ulyssecrn/PCBGolf/assets/renders/hero-bottom.png

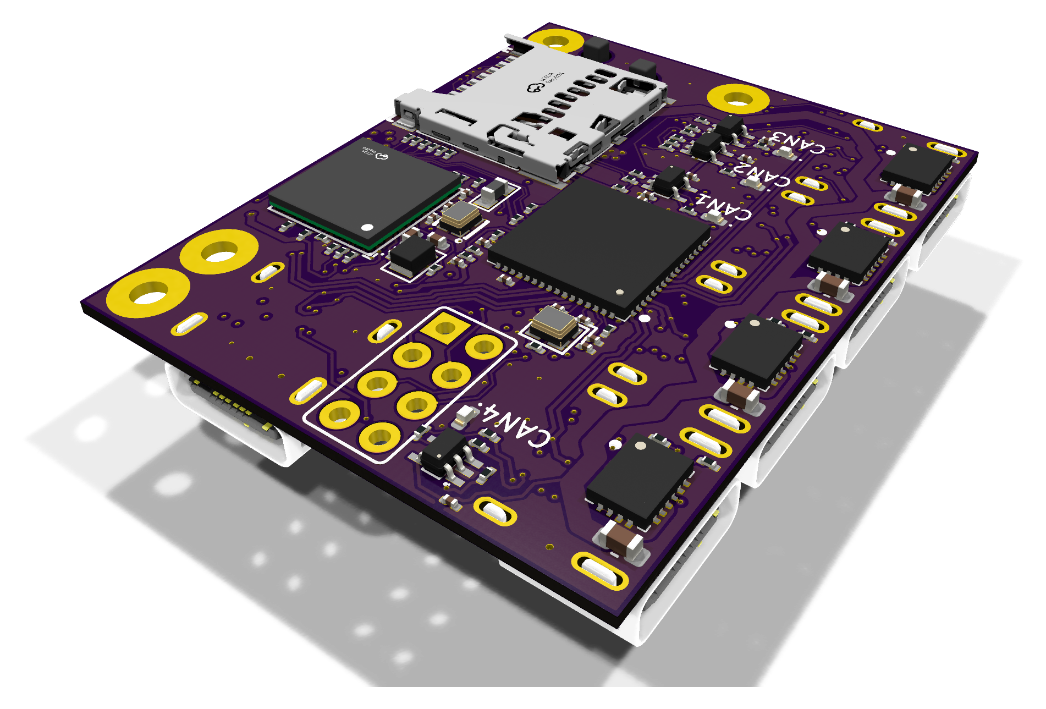
assets/renders/hero-bottom.png
