ulyssecrn/PCBGolf/pcbgolf.kicad_pcb

## KiCad design pcbgolf.kicad_pcb (2026-10-13)

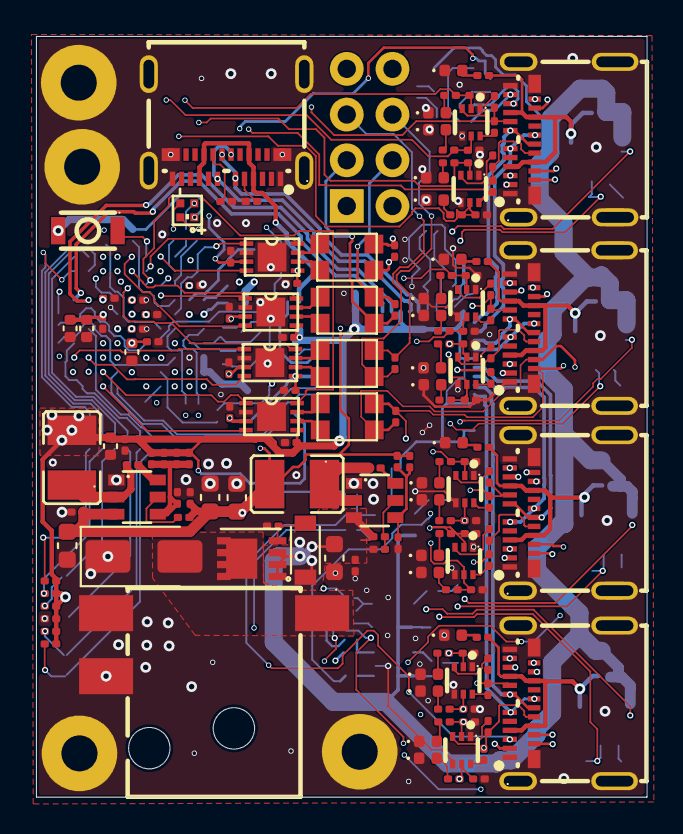
[picture p5: board pcbgolf.kicad_pcb from above]

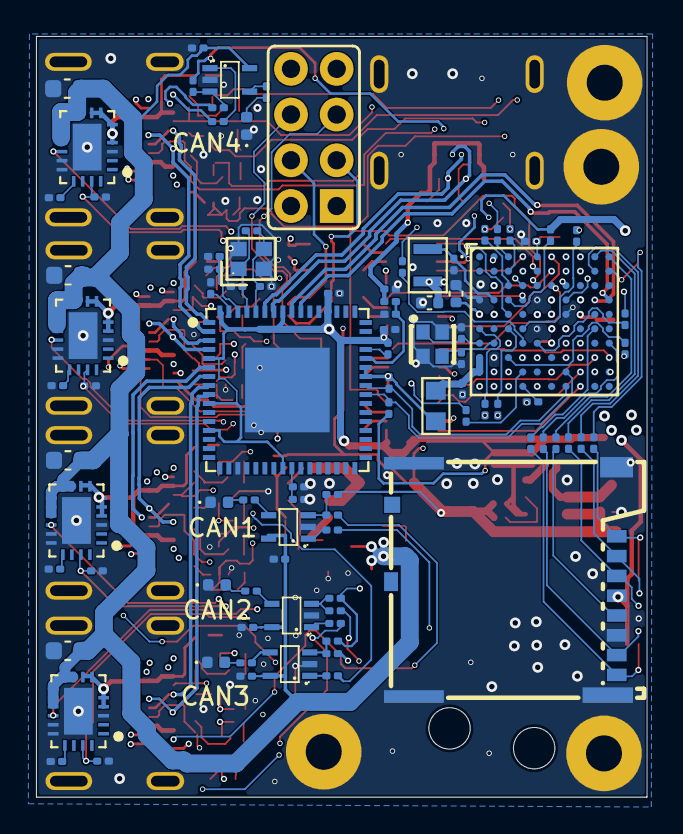
[picture p6: board pcbgolf.kicad_pcb from below]

Board: 4 copper layers, 33.9 x 42.3 mm, 253 parts (93 on the bottom side), 196 nets.

Parts:
BH1, BH2, BH3, BH4: M2_BOLT
C1, C3, C12, C13: 10uF; C_0603_1608Metric
C2, C4, C5, C7, C9, C11, C16, C18, C22, C23, C24, C26, C27, C30, C31, C35, C36, C38, C39, C40, C41, C42, C43, C44, C45, C46, C47, C48, C49, C55: 100nF; C_0201_0603Metric
C6, C10: DNP; C_0201_0603Metric
C8, C15, C19, C20, C21: 10uF; C_0402_1005Metric
C14, C17, C28, C32: 12pF; C_0201_0603Metric
C25: 220pF; C_0201_0603Metric
C29, C33, C34, C37: 10u; C_0201_0603Metric
C50, C51, C52, C53: 10u; C_0603_1608Metric
C54: 4.7uF; C_0402_1005Metric
D1: TVS-BI-DO214AA; D_SMA
D2: DIODEDB2W40100L; SOD-123F
J1: DCBARRELSMT; DC-IN-SMD_DC-044D-2.5A-2.0-SMT
J2: MICRO_SD-0472192001; microSD_Molex_5033981892
J3: USB-C-FEMALE; USB-C-J3-molex
J4: CAN; 2X04
J5, J6, J7, J8: USB-C-FEMALEGCT; USB-C-SMD_TYPE-C-USB-18
L1, L2: 3u3; IND_3225_3R3
L3: L-US-L2; 0603-L
L4: 2u2; 0806
L5, L6, L7, L8: ACT1210D_CHOKE; CHOKE-3.2X2.5
LED1: CREE-RGB-CLMVC; RGB_NH-B1010
LED2: CAN0; LED_0402_1005Metric
LED3: CAN1; LED_0402_1005Metric
LED4: CAN2; LED_0402_1005Metric
LED5: CAN3; LED_0402_1005Metric
LED6, LED7, LED8, LED9: CH1_PWR; LED_0402_1005Metric
LED10, LED11, LED12, LED13, LED14, LED15, LED16, LED17: LED_RED_0402; LED_0402_1005Metric
LED30, LED31, LED32, LED33, LED34, LED35, LED36, LED37: LED_GREEN_0402; LED_0402_1005Metric
Q1: SIS427-VI; PP-1212-8
Q2, Q3, Q4, Q5, Q6, Q7, Q8, Q9: NFET-DUAL-COMMON-SOURCE-QS5K2; SSM6N44FE-SOT563-remap
R1, R3, R7, R8, R9, R11, R12, R28, R29, R30, R33, R34, R35, R36, R37, R50, R51, R53, R54, R56, R57, R59, R60, R78, R79, R80, R81, R98, R99, R100, R101, R102, R103, R104, R105, R122, R123, R124, R125: 10k; R_0201_0603Metric
R2, R21, R23, R90, R92, R94, R96, R114, R116, R118, R120: 1k; R_0201_0603Metric
R4, R5, R6, R13, R14, R15, R16, R17, R18, R19, R20, R24, R25, R52, R55, R58, R61: 100k; R_0201_0603Metric
R10: 52k3; R_0201_0603Metric
R22, R62, R63, R64, R65: 2k7; R_0201_0603Metric
R26: 1M; R_0201_0603Metric
R27: 12k; R_0201_0603Metric
R32, R44: 5.1k; R_0201_0603Metric
R38, R39, R40, R41, R42, R43: 0R; R_0201_0603Metric
R46, R47, R48, R49: 60; R_0201_0603Metric
R66, R67, R68, R69: 28k; R_0201_0603Metric
R70, R71, R72, R73: 33k; R_0201_0603Metric
R74, R75, R76, R77: 3k3; R_0201_0603Metric
R82, R83, R84, R85, R86, R87, R88, R89, R91, R93, R95, R97, R106, R107, R108, R109, R110, R111, R112, R113, R115, R117, R119, R121: 100; R_0201_0603Metric
SW1: SPST-2-4PIN; SW_TS2306A
U1, U2: AP62300T; SOT23-6
U3: STM32H725VGH6; STM32H725-TFBGA100-remap
U4: USB2517; QFN64-9X9
U5, U6, U7, U8: MCP2542FDT-E/MNY; TDFN8_2X3MC_MCH
U13, U14, U15, U16: TPS25942; WQFN20
U17, U18, U19, U20: TLV9101IDCKR; TLV9101-SC70-5
Y1: 25MHz; Crystal_2016_25M
Y2: 24MHz; Crystal_2016_24M

Connections:
+3V3: C6.2, C7.1, C8.1, C19.1, C20.1, C23.1, C24.1, C26.1, C27.1, C30.2, C31.2, C37.1, C42.1, C43.1, C44.1, C45.1, C54.1, C55.1, J2.4 (VDD), L1.2, L3.1, LED1.U1 (COM+), R4.1, R5.1, R6.1, R11.1, R28.1, R29.1, R30.1, R33.1, R34.1, R35.1, R36.1, R37.1, SW1.B (S), SW1.B' (S1), U3.7 (VDD), U3.8 (VBAT), U3.13 (VDD), U3.16 (VDDSMPS), U3.19 (VDD), U3.91 (VDD33USB), U4.5 (VDDA33), U4.10 (VDDA33), U4.13 (CFG_SEL2), U4.24 (VDD33CR), U4.42 (CFG_SEL1), U4.43 (RESET_N), U4.46 (VDD33), U4.52 (VDDA33), U4.57 (VDDA33), U4.64 (VDD33PLL), U5.5 (VIO), U6.5 (VIO), U7.5 (VIO), U8.5 (VIO)
+5V: C1.1, C2.1, C10.2, C11.1, C12.1, C13.1, C38.1, C39.1, C40.1, C41.1, L2.2, R1.1, R10.2, R52.2, R55.2, R58.2, R61.2, U1.3 (IN), U5.3 (VDD), U6.3 (VDD), U7.3 (VDD), U8.3 (VDD)
+12V: C3.1, C5.1, C46.1, C47.1, C48.1, C49.1, C50.1, C51.1, C52.1, C53.1, D2.1 (C), Q1.1 (S), Q1.2 (S), Q1.3 (S), R7.1, U2.3 (IN), U13.9 (VIN), U13.10 (VIN), U13.11 (VIN), U13.12 (VIN), U13.13 (VIN), U14.9 (VIN), U14.10 (VIN), U14.11 (VIN), U14.12 (VIN), U14.13 (VIN), U15.9 (VIN), U15.10 (VIN), U15.11 (VIN), U15.12 (VIN), U15.13 (VIN), U16.9 (VIN), U16.10 (VIN), U16.11 (VIN), U16.12 (VIN), U16.13 (VIN), U17.5 (V+), U18.5 (V+), U19.5 (V+), U20.5 (V+)
BTN: R12.2, SW1.A, SW1.A' (P1), U3.4 (PE5), U3.135 (BOOT0)
CAN0_EN: U3.134 (PB7), U5.8 (STBY)
CAN0_H: J4.2, J5.A2 (TX1+), J6.A2 (TX1+), J7.A2 (TX1+), J8.A2 (TX1+), L5.4, R46.2, R50.1
CAN0_L: J4.1, J5.A3 (TX1-), J6.A3 (TX1-), J7.A3 (TX1-), J8.A3 (TX1-), L5.3, R46.1, R51.1
CAN0_RX: U3.136 (PB8), U5.4 (RXD)
CAN0_TX: U3.137 (PB9), U5.1 (TXD)
CAN1_EN: U3.130 (PB3(JTDO), U6.8 (STBY)
CAN1_H: J4.4, J5.A11 (RX2+), J6.A11 (RX2+), J7.A11 (RX2+), J8.A11 (RX2+), L6.4, R47.2, R53.1
CAN1_L: J4.3, J5.A10 (RX2-), J6.A10 (RX2-), J7.A10 (RX2-), J8.A10 (RX2-), L6.3, R47.1, R54.1
CAN1_RX: U3.132 (PB5), U6.4 (RXD)
CAN1_TX: U3.133 (PB6), U6.1 (TXD)
CAN2_EN: U3.121 (PD7), U7.8 (STBY)
CAN2_H: J4.6, J5.B2 (TX2+), J6.B2 (TX2+), J7.B2 (TX2+), J8.B2 (TX2+), L7.4, R48.2, R56.1
CAN2_L: J4.5, J5.B3 (TX2-), J6.B3 (TX2-), J7.B3 (TX2-), J8.B3 (TX2-), L7.3, R48.1, R57.1
CAN2_RX: U3.82 (PD12), U7.4 (RXD)
CAN2_TX: U3.83 (PD13), U7.1 (TXD)
CAN3_EN: U3.131 (PB4(NJTRST)), U8.8 (STBY)
CAN3_H: J4.8, J5.B11 (RX1+), J6.B11 (RX1+), J7.B11 (RX1+), J8.B11 (RX1+), L8.4, R49.2, R59.1
CAN3_L: J4.7, J5.B10 (RX1-), J6.B10 (RX1-), J7.B10 (RX1-), J8.B10 (RX1-), L8.3, R49.1, R60.1
CAN3_RX: U3.72 (PB12), U8.4 (RXD)
CAN3_TX: U3.73 (PB13), U8.1 (TXD)
CH1_D_N: J5.A7 (D-A), J5.B7 (D-B), U4.1 (USBDN1_DM)
CH1_D_P: J5.A6 (D+A), J5.B6 (D+B), U4.2 (USBDN1_DP)
CH1_IMON: R70.2, U3.47 (PC4), U13.19 (IMON)
CH1_PWR_EN: U3.37 (PA0), U13.14 (EN)
CH1_SBU1: J5.A8 (SBU1), R19.2, R90.2, R91.2
CH1_SBU1_IGN: Q2.1 (G1), R78.1, R83.2, U3.120 (PD6)
CH1_SBU1_RELAY: Q2.3 (G2), R82.2, R98.2, U3.115 (PD3)
CH1_SBU2: J5.B8 (SBU2), R20.2, R114.2, R115.2
CH1_SBU2_IGN: Q6.1 (G1), R102.1, R107.2, U3.138 (PE0)
CH1_SBU2_RELAY: Q6.3 (G2), R106.2, R122.2, U3.116 (PD4)
CH2_D_N: J6.A7 (D-A), J6.B7 (D-B), U4.3 (USBDN2_DM)
CH2_D_P: J6.A6 (D+A), J6.B6 (D+B), U4.4 (USBDN2_DP)
CH2_IMON: R71.2, U3.45 (PA6), U14.19 (IMON)
CH2_PWR_EN: U3.38 (PA1), U14.14 (EN)
CH2_SBU1: J6.A8 (SBU1), R15.2, R92.2, R93.2
CH2_SBU1_IGN: Q3.1 (G1), R79.1, R85.2, U3.113 (PD1)
CH2_SBU1_RELAY: Q3.3 (G2), R84.2, R99.2, U3.139 (PE1)
CH2_SBU1_SENSE: R15.1, U3.48 (PC5)
CH2_SBU2: J6.B8 (SBU2), R13.2, R116.2, R117.2
CH2_SBU2_IGN: Q7.1 (G1), R103.1, R109.2, U3.112 (PD0)
CH2_SBU2_RELAY: Q7.3 (G2), R108.2, R123.2, U3.117 (PD5)
CH2_SBU2_SENSE: R13.1, U3.40 (PA3)
CH3_D_N: J7.A7 (D-A), J7.B7 (D-B), U4.6 (USBDN3_DM)
CH3_D_P: J7.A6 (D+A), J7.B6 (D+B), U4.7 (USBDN3_DP)
CH3_IMON: R72.2, U3.44 (PA5), U15.19 (IMON)
CH3_PWR_EN: U3.43 (PA4), U15.14 (EN)
CH3_SBU1: J7.A8 (SBU1), R17.2, R94.2, R95.2
CH3_SBU1_IGN: Q4.1 (G1), R80.1, R87.2, U3.84 (PD14)
CH3_SBU1_RELAY: Q4.3 (G2), R86.2, R100.2, U3.85 (PD15)
CH3_SBU2: J7.B8 (SBU2), R18.2, R118.2, R119.2
CH3_SBU2_IGN: Q8.1 (G1), R104.1, R111.2, U3.57 (PE7)
CH3_SBU2_RELAY: Q8.3 (G2), R110.2, R124.2, U3.81 (PD11)
CH4_D_N: J8.A7 (D-A), J8.B7 (D-B), U4.8 (USBDN4_DM)
CH4_D_P: J8.A6 (D+A), J8.B6 (D+B), U4.9 (USBDN4_DP)
CH4_IMON: R73.2, U3.50 (PB1), U16.19 (IMON)
CH4_PWR_EN: U3.46 (PA7), U16.14 (EN)
CH4_SBU1: J8.A8 (SBU1), R16.2, R96.2, R97.2
CH4_SBU1_IGN: Q5.1 (G1), R81.1, R89.2, U3.77 (PD9)
CH4_SBU1_RELAY: Q5.3 (G2), R88.2, R101.2, U3.58 (PE8)
CH4_SBU1_SENSE: R16.1, U3.49 (PB0)
CH4_SBU2: J8.B8 (SBU2), R14.2, R120.2, R121.2
CH4_SBU2_IGN: Q9.1 (G1), R105.1, R113.2, U3.76 (PD8)
CH4_SBU2_RELAY: Q9.3 (G2), R112.2, R125.2, U3.78 (PD10)
CH4_SBU2_SENSE: R14.1, U3.39 (PA2)
GND: BH1.0 (1_0), BH2.0 (1_0), BH3.0 (1_0), BH4.0 (1_0), C1.2, C2.2, C3.2, C5.2, C7.2, C8.2, C11.2, C12.2, C13.2, C14.2, C15.2, C16.2, C17.2, C18.2, C19.2, C20.2, C21.2, C22.2, C23.2, C24.2, C25.2, C26.2, C27.2, C28.2, C29.2, C30.1, C31.1, C32.2, C33.2, C34.2, C35.1, C36.1, C37.2, C38.2, C39.2, C40.2, C41.2, C42.2, C43.2, C44.2, C45.2, C46.2, C47.2, C48.2, C49.2, C50.2, C51.2, C52.2, C53.2, C54.2, C55.2, D1.1, J1.GND (GNDBREAK), J1.GNDBREAK (GND), J2.6 (VSS), J2.G1 (GND), J2.G2 (GND), J2.G3 (GND), J2.G4 (GND), J3.A1 (GND), J3.A12 (GND), J3.B1 (GND), J3.B1T (GND), J3.B12 (GND), J3.B12T (GND), J3.S1B (SHIELDA), J3.S1T (SHIELDA), J3.S1TH (SHIELDA), J3.S2B (SHIELDA), J3.S2T (SHIELDA), J3.S2TH (SHIELDA), J3.S3B (SHIELDB), J3.S3T (SHIELDB), J3.S3TH (SHIELDB), J3.S4B (SHIELDB), J3.S4T (SHIELDB), J3.S4TH (SHIELDB), J5.A1 (GND), J5.A12 (GND), J5.B1 (GND), J5.B12 (GND), J5.S1 (SHIELDA), J5.S2 (SHIELDA), J5.S3 (SHIELDA), J5.S4 (SHIELDA), J5.S11 (SHIELDB), J5.S12 (SHIELDB), J5.S13 (SHIELDB), J5.S14 (SHIELDB), J6.A1 (GND), J6.A12 (GND), J6.B1 (GND), J6.B12 (GND), J6.S1 (SHIELDA), J6.S2 (SHIELDA), J6.S3 (SHIELDA), J6.S4 (SHIELDA), J6.S11 (SHIELDB), J6.S12 (SHIELDB), J6.S13 (SHIELDB), J6.S14 (SHIELDB), J7.A1 (GND), J7.A12 (GND), J7.B1 (GND), J7.B12 (GND), J7.S1 (SHIELDA), J7.S2 (SHIELDA), J7.S3 (SHIELDA), J7.S4 (SHIELDA), J7.S11 (SHIELDB), J7.S12 (SHIELDB), J7.S13 (SHIELDB), J7.S14 (SHIELDB), J8.A1 (GND), J8.A12 (GND), J8.B1 (GND), J8.B12 (GND), J8.S1 (SHIELDA), J8.S2 (SHIELDA), J8.S3 (SHIELDA), J8.S4 (SHIELDA), J8.S11 (SHIELDB), J8.S12 (SHIELDB), J8.S13 (SHIELDB), J8.S14 (SHIELDB), LED2.C, LED3.C, LED4.C, LED5.C, LED6.C, LED7.C, LED8.C, LED9.C, LED10.C, LED11.C, LED12.C, LED13.C, LED14.C, LED15.C, LED16.C, LED17.C, LED30.C, LED31.C, LED32.C, LED33.C, LED34.C, LED35.C, LED36.C, LED37.C, Q2.2 (S), Q3.2 (S), Q4.2 (S), Q5.2 (S), Q6.2 (S), Q7.2 (S), Q8.2 (S), Q9.2 (S), R2.1, R3.2, R8.2, R9.2, R12.1, R25.1, R27.1, R32.2, R44.2, R66.1, R67.1, R68.1, R69.1, R70.1, R71.1, R72.1, R73.1, R78.2, R79.2, R80.2, R81.2, R98.1, R99.1, R100.1, R101.1, R102.2, R103.2, R104.2, R105.2, R122.1, R123.1, R124.1, R125.1, U1.1 (GND), U2.1 (GND), U3.6 (VSS), U3.12 (VSS), U3.14 (VSSSMPS), U3.18 (VSS), U3.33 (VSS), U3.34 (VSSA), U4.19 (TEST), U4.PAD (VSS), U5.2 (VSS), U5.PAD (EPAD), U6.2 (VSS), U6.PAD (EPAD), U7.2 (VSS), U7.PAD (EPAD), U8.2 (VSS), U8.PAD (EPAD), U13.3 (PGTH), U13.15 (OVP), U13.16 (GND), U13.PAD (GND), U14.3 (PGTH), U14.15 (OVP), U14.16 (GND), U14.PAD (GND), U15.3 (PGTH), U15.15 (OVP), U15.16 (GND), U15.PAD (GND), U16.3 (PGTH), U16.15 (OVP), U16.16 (GND), U16.PAD (GND), U17.2 (V-), U18.2 (V-), U19.2 (V-), U20.2 (V-), Y1.2 (3), Y1.4 (3), Y2.2 (3), Y2.4 (3)
HUB_SCL: R30.2, U3.66 (PB10), U4.41 (SCL)
HUB_SDA: R28.2, U3.67 (PB11), U4.40 (SDA)
LED_B: R23.2, U3.1 (PE2)
LED_G: R22.2, U3.2 (PE3)
LED_R: R21.2, U3.3 (PE4)
unnamed: D2.2 (A), Q1.4 (G), R2.2
unnamed: D1.2, J1.PWR1 (PWR), Q1.5 (D), Q1.6 (D), Q1.7 (D), Q1.8 (D), Q1.9 (D)
unnamed: J2.2 (CD/DAT3), R36.2, R41.2
unnamed: J2.5 (CLK), R43.2
unnamed: J2.3 (CMD), R37.2, R42.2
unnamed: J2.7 (DAT0), R33.2, R38.2
unnamed: J2.8 (DAT1), R34.2, R39.2
unnamed: J2.1 (DAT2), R35.2, R40.2
unnamed: J3.A5 (CC1), R32.1
unnamed: J3.B5 (CC2), J3.B5T (CC2), R44.1
unnamed: J3.B11 (RX1+), J3.B11T (RX1+)
unnamed: J3.B10 (RX1-), J3.B10T (RX1-)
unnamed: J3.B8 (SBU2), J3.B8T (SBU2)
unnamed: J3.B2 (TX2+), J3.B2T (TX2+)
unnamed: J3.B3 (TX2-), J3.B3T (TX2-)
unnamed: J5.A4 (VBUS), J5.A9 (VBUS), J5.B4 (VBUS), J5.B9 (VBUS), R74.1, U13.4 (VOUT), U13.5 (VOUT), U13.6 (VOUT), U13.7 (VOUT), U13.8 (VOUT)
unnamed: J6.A4 (VBUS), J6.A9 (VBUS), J6.B4 (VBUS), J6.B9 (VBUS), R75.1, U14.4 (VOUT), U14.5 (VOUT), U14.6 (VOUT), U14.7 (VOUT), U14.8 (VOUT)
unnamed: J7.A4 (VBUS), J7.A9 (VBUS), J7.B4 (VBUS), J7.B9 (VBUS), R76.1, U15.4 (VOUT), U15.5 (VOUT), U15.6 (VOUT), U15.7 (VOUT), U15.8 (VOUT)
unnamed: J8.A4 (VBUS), J8.A9 (VBUS), J8.B4 (VBUS), J8.B9 (VBUS), R77.1, U16.4 (VOUT), U16.5 (VOUT), U16.6 (VOUT), U16.7 (VOUT), U16.8 (VOUT)
unnamed: LED1.U4 (B-), R23.1
unnamed: LED1.U3 (G-), R22.1
unnamed: LED1.U2 (R-), R21.1
unnamed: LED2.A, R62.2
unnamed: LED3.A, R63.2
unnamed: LED4.A, R64.2
unnamed: LED5.A, R65.2
unnamed: LED6.A, R74.2
unnamed: LED7.A, R75.2
unnamed: LED8.A, R76.2
unnamed: LED9.A, R77.2
unnamed: LED10.A, R83.1
unnamed: LED11.A, R85.1
unnamed: LED12.A, R87.1
unnamed: LED13.A, R89.1
unnamed: LED14.A, R107.1
unnamed: LED15.A, R109.1
unnamed: LED16.A, R111.1
unnamed: LED17.A, R113.1
unnamed: LED30.A, R82.1
unnamed: LED31.A, R84.1
unnamed: LED32.A, R86.1
unnamed: LED33.A, R88.1
unnamed: LED34.A, R106.1
unnamed: LED35.A, R108.1
unnamed: LED36.A, R110.1
unnamed: LED37.A, R112.1
unnamed: Q2.5 (D1), R90.1
unnamed: Q2.4 (D2), R91.1
unnamed: Q3.5 (D1), R92.1
unnamed: Q3.4 (D2), R93.1
unnamed: Q4.5 (D1), R94.1
unnamed: Q4.4 (D2), R95.1
unnamed: Q5.5 (D1), R96.1
unnamed: Q5.4 (D2), R97.1
unnamed: Q6.5 (D1), R114.1
unnamed: Q6.4 (D2), R115.1
unnamed: Q7.5 (D1), R116.1
unnamed: Q7.4 (D2), R117.1
unnamed: Q8.5 (D1), R118.1
unnamed: Q8.4 (D2), R119.1
unnamed: Q9.5 (D1), R120.1
unnamed: Q9.4 (D2), R121.1
unnamed: C4.1, U1.6 (BST)
unnamed: R1.2, U1.5 (EN)
unnamed: C6.1, R3.1, R4.2, R5.2, R6.2, U1.4 (FB)
unnamed: C4.2, L1.1, U1.2 (SW)
unnamed: C9.1, U2.6 (BST)
unnamed: R7.2, R8.1, U2.5 (EN)
unnamed: C10.1, R9.1, R10.1, U2.4 (FB)
unnamed: C9.2, L2.1, U2.2 (SW)
unnamed: R17.1, U3.28 (PC0)
unnamed: R18.1, U3.29 (PC1)
unnamed: R19.1, U3.30 (PC2_C)
unnamed: R20.1, U3.31 (PC3_C)
unnamed: R11.2, U3.142 (PDR_ON)
unnamed: C14.1, U3.25 (PH0), Y1.1
unnamed: C17.1, U3.26 (PH1), Y1.3 (2)
unnamed: R27.2, U4.63 (RBIAS)
unnamed: R29.2, U4.45 (SUSP_IND)
unnamed: R24.1, R25.2, U4.44 (VBUS_DET)
unnamed: C33.1, C35.2, U4.25 (VDD18)
unnamed: C34.1, C36.2, U4.62 (VDD18PLL)
unnamed: C28.1, R26.2, U4.61 (XTAL1), Y2.1
unnamed: C32.1, R26.1, U4.60 (XTAL2), Y2.3 (2)
unnamed: L5.1, U5.7 (CANH)
unnamed: L5.2, U5.6 (CANL)
unnamed: L6.1, U6.7 (CANH)
unnamed: L6.2, U6.6 (CANL)
unnamed: L7.1, U7.7 (CANH)
unnamed: L7.2, U7.6 (CANL)
unnamed: L8.1, U8.7 (CANH)
unnamed: L8.2, U8.6 (CANL)
unnamed: R66.2, U13.17 (ILIM)
unnamed: R67.2, U14.17 (ILIM)
unnamed: R68.2, U15.17 (ILIM)
unnamed: R69.2, U16.17 (ILIM)
unnamed: R50.2, U17.1 (IN+)
unnamed: R51.2, R52.1, U17.3 (IN−)
unnamed: R62.1, U17.4 (OUT)
unnamed: R53.2, U18.1 (IN+)
unnamed: R54.2, R55.1, U18.3 (IN−)
unnamed: R63.1, U18.4 (OUT)
unnamed: R56.2, U19.1 (IN+)
unnamed: R57.2, R58.1, U19.3 (IN−)
unnamed: R64.1, U19.4 (OUT)
unnamed: R59.2, U20.1 (IN+)
unnamed: R60.2, R61.1, U20.3 (IN−)
unnamed: R65.1, U20.4 (OUT)
SD_CLK: R43.1, U3.111 (PC12)
SD_CMD: R42.1, U3.114 (PD2)
SD_D0: R38.1, U3.95 (PC8)
SD_D1: R39.1, U3.96 (PC9)
SD_D2: R40.1, U3.109 (PC10)
SD_D3: R41.1, U3.110 (PC11)
STM_D_N: U3.100 (PA11), U4.55 (USBDN7_DM)
STM_D_P: U3.101 (PA12), U4.56 (USBDN7_DP)
USB_D_N: J3.A7 (D-A), J3.B7 (D-B), J3.B7T (D-B), U4.58 (USBUP_DM)
USB_D_P: J3.A6 (D+A), J3.B6 (D+B), J3.B6T (D+B), U4.59 (USBUP_DP)
VBUS: C29.1, J3.A4 (VBUS), J3.A9 (VBUS), J3.B4 (VBUS), J3.B4T (VBUS), J3.B9 (VBUS), J3.B9T (VBUS), R24.2
VDDA: C22.1, L3.2, U3.35 (VREF+), U3.36 (VDDA)
VDDLDO: C15.1, C16.1, C18.1, C21.1, L4.1, U3.17 (VFBSMPS), U3.68 (VCAP), U3.70 (VDDLDO), U3.103 (VCAP), U3.105 (VDDLDO)
VLXSMPS: C25.1, L4.2, U3.15 (VLXSMPS)
