ulyssecrn/PCBGolf/(commit log)

2026-09-20 Miniaturize BOM: JLC-sourced smaller parts + footprint fixes
    Component/package reductions (all JLC-manufacturable, verified in stock):
    - MCU STM32H725 -> UFBGA-169 (7x7), footprint-remap keeps LQFP144 symbol
    - USB-C J3 + J5-J8 -> Molex 1054500101 flat SMD (J3 was through-hole DX07);
    J3 footprint carries all 48 DX07-symbol pads (B*T tails + shields co-located)
    - Dual N-FETs Q2-Q9 -> SSM6N44FE SOT-563 (common-source remap, both S -> GND)
    - Op-amps -> NCS20071 TSOT-23-5
    - RGB LED1 -> NH-B1010 1.0x1.0 common-anode (no rewiring)
    - Bi-color LEDs split into single 0402 red/green; CHIPLED -> 0402
    - Crystals Y1/Y2 -> 2016; barrel jack -> DC-044D 7mm (MPN fix)
    - Passives -> 0201; 10uF bulk 0805 -> 0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
2026-09-21 Set up net classes, predefined track/via sizes, JLC-aligned constraints
    - Net classes: Power/USB/CAN + tightened Default, assigned by name pattern
    - Predefined tracks (0.1-0.6mm), vias (0.4/0.2..0.8/0.4), diff pairs
    - Constraints: copper-to-edge 0.025->0.2mm, min clearance/track ->0.0889,
    min connection ->0.13, silk stroke ->0.15 (JLC 4-layer capability)
2026-09-21 Re-apply net classes, predefined sizes, constraints (survived KiCad close)
2026-09-21 Tighten Default to 0.1mm track / 0.35-0.2 via; add 0.089mm track + 0.35/0.2 via predefined; lower via floors
2026-09-21 USB/CAN vias 0.35/0.2; CAN track 0.25->0.15 (data diff, not power)
2026-09-21 Add TLV9101 (SC-70-5) op-amp symbol+footprint for CAN-LED driver
    Smaller replacement for NCS20071 (SOT-23-5). 2.7-16V so works on +5V or +12V.
2026-09-21 Restore footprint remaps clobbered by Update-Symbols-from-Libraries; shrink M2 pad
    - Re-applied 30 per-instance footprint overrides (FETs, crystals, inductors,
    microSD, USB-C J3, RGB, TVS, button, caps) that reverted to library defaults
    - M2_BOLT pad 4.2mm -> 3.0mm (keeps plated GND, reclaims corner margin)
    - Includes user's TLV9101 op-amp swap on U9-U12
2026-09-21 Revert M2 pad to 4.2mm (sized for screw-head GND contact)
2026-09-21 Add stemless Molex 5033981892 microSD footprint (1.28mm, no locating pins) + 3D model
    Drop-in for J2: pads 1-8 + shell renamed to G1-G4 to match existing symbol.
2026-09-21 Attach 7x7 UFBGA-169 3D model to STM32 footprint (was broken KICAD10_3DMODEL_DIR ref)
    Uses KiCad's BGA-144 7.0x7.0 P0.5mm body (identical package outline) via KIPRJMOD path.
2026-09-21 WIP: layout in progress (placement, routing, footprint/model swaps)
2026-09-27 WIP: migrate STM32H725 to TFBGA100, reorder CH pins, routing progress
    - U3 footprint UFBGA169 -> TFBGA100 (pads renamed to symbol pin numbers,
    ST NSMD pad/mask sizes) + 3D model; port F/G signals remapped
    - CHx PWR_EN/IMON/SBU pins reordered CH1..CH4 top-to-bottom for In1 escape
    (IMON kept on ADC pins; firmware pin map must follow)
    - Placement/routing progress; pours, vias, netclass tweaks
2026-10-12 Finish routing; fix BTN pin, U3 MPN, J1 STEP offset, SMD attributes
2026-10-12 Move CH2/CH4 SBU voltage sense to ADC pins (PA2, PA3, PC5, PB0)
